Si-Sandman/usb2pa/README.md

USB2PA Project <br>
USB2 Protocol Analyzer Wing for the Papilio-Pro FPGA Board.
