Si-Sandman/usb2pa/doc/usb2pa_pinout.xls

PP Sch Sort Order | FPGA Name | Papilio Pro FPGA Pin | FPGA Usage | Papilio Pro Eagle Netname | Corresponding Papilio One Pin | LogicWing Function | USB2PA HDR | USB2PA HDR PIN | USB2PA NetName | USB2PA LogicPort Hdr Pin | USB2PA LogicPort Wire / Tip
33 | IO_L83N_VREF_3 | 1 | IOBS | CS
32 | IO_L83P_3 | 2 | IOBM | !RAS
140 | GND | 3 |  | GND
58 | VCCO_3 | 4 |  | 3V3
35 | IO_L52N_3 | 5 | IOBS | !CAS
34 | IO_L52P_3 | 6 | IOBM | !WE
37 | IO_L51N_3 | 7 | IOBS | DQML
36 | IO_L51P_3 | 8 | IOBM | DQ7
39 | IO_L50N_3 | 9 | IOBS | DQ0
38 | IO_L50P_3 | 10 | IOBM | DQ1
41 | IO_L49N_3 | 11 | IOBS | DQ2
40 | IO_L49P_3 | 12 | IOBM | DQ3
136 | GND | 13 |  | GND
43 | IO_L44N_GCLK20_3 | 14 | IOBS | DQ4
42 | IO_L44P_GCLK21_3 | 15 | IOBM | DQ5
45 | IO_L43N_GCLK22_IRDY2_3 | 16 | IOBS | DQ6
44 | IO_L43P_GCLK23_3 | 17 | IOBM | DQMH
60 | VCCO_3 | 18 |  | 3V3
129 | VCCINT | 19 |  | 1V2
123 | VCCAUX | 20 |  | 3V3
47 | IO_L42N_GCLK24_3 | 21 | IOBS | DQ8
46 | IO_L42P_GCLK25_TRDY2_3 | 22 | IOBM | DQ9
49 | IO_L41N_GCLK26_3 | 23 | IOBS | DQ10
48 | IO_L41P_GCLK27_3 | 24 | IOBM | DQ11
139 | GND | 25 |  | GND
51 | IO_L37N_3 | 26 | IOBS | DQ12
50 | IO_L37P_3 | 27 | IOBM | DQ13
130 | VCCINT | 28 |  | 1V2
53 | IO_L36N_3 | 29 | IOBS | DQ14
52 | IO_L36P_3 | 30 | IOBM | DQ15
59 | VCCO_3 | 31 |  | 3V3
55 | IO_L2N_3 | 32 | IOBS | CLK
54 | IO_L2P_3 | 33 | IOBM | CKE
57 | IO_L1N_VREF_3 | 34 | IOBS | A12
56 | IO_L1P_3 | 35 | IOBM | A11
124 | VCCAUX | 36 |  | 3V3
120 | PROGRAM_B_2 | 37 |  | REBOOT
118 | IO_L65N_CSO_B_2 | 38 | IOBS | FLASH_CS
119 | IO_L65P_INIT_B_2 | 39 | IOBM | nc
116 | IO_L64N_D9_2 | 40 | IOBS | A9
117 | IO_L64P_D8_2 | 41 | IOBM | A8
90 | VCCO_2 | 42 |  | 3V3
114 | IO_L62N_D6_2 | 43 | IOBS | A7
115 | IO_L62P_D5_2 | 44 | IOBM | A6
112 | IO_L49N_D4_2 | 45 | IOBS | A5
113 | IO_L49P_D3_2 | 46 | IOBM | A4
110 | IO_L48N_RDWR_B_VREF_2 | 47 | IOBS | W1_B16 | 22 | I-Joystick Select | PP_HDRA_B_IO | A32 | VBUS_EN | -- | --
111 | IO_L48P_D7_2 | 48 | IOBM | W1_A1 | 18 | O-AN3 | PP_HDRA_B_IO | B32 | PHYRESET (RESET) | 39 | BLU / GRN
141 | GND | 49 |  | GND
108 | IO_L31N_GCLK30_D15_2 | 50 | IOBS | W1_B15 | 25 | I-Joystick Up | PP_HDRA_B_IO | A31 | VBUS_FLAG | -- | --
109 | IO_L31P_GCLK31_D14_2 | 51 | IOBM | W1_A2 | 23 | O-DataPoint Segment | PP_HDRA_B_IO | B31 | unused
131 | VCCINT | 52 |  | 1V2
125 | VCCAUX | 53 |  | 3V3
142 | GND | 54 |  | GND
106 | IO_L30N_GCLK0_USERCCLK_2 | 55 | IOBS | W1_B14 | 32 | I-Joystick Down | PP_HDRA_B_IO | A30 | XCVRSEL0 | 32 | BRN / GRN
107 | IO_L30P_GCLK1_D13_2 | 56 | IOBM | W1_A3 | 26 | O-AN2 | PP_HDRA_B_IO | B30 | unused
104 | IO_L14N_D12_2 | 57 | IOBS | W1_B13 | 34 | I-Joystick Left | PP_HDRA_B_IO | A29 | TXREADY | 34 | ORA / GRN
105 | IO_L14P_D11_2 | 58 | IOBM | W1_A4 | 33 | O-E Segment | PP_HDRA_B_IO | B29 | TERMSEL | 31 | BLK / GRN
102 | IO_L13N_D10_2 | 59 | IOBS | W1_B12 | 36 | I-Joystick Right | PP_HDRA_B_IO | A28 | TXVALID | 28 | PUR / YEL
103 | IO_L13P_M1_2 | 60 | IOBM | GND
100 | IO_L12N_D2_MISO3_2 | 61 | IOBS | W1_A5 | 35 | O-F Segment | PP_HDRA_B_IO | B28 | SUSPENDN | 33 | RED / GRN
101 | IO_L12P_D1_MISO2_2 | 62 | IOBM | W1_B11 | 41 | O-Audio Output (delta sigma dac) |  | A27 | unused
91 | VCCO_2 | 63 |  | 3V3
98 | IO_L3N_MOSI_CSI_B_MISO0_2 | 64 | IOBS | FLASH_SI
99 | IO_L3P_D0_DIN_MISO_MISO1_2 | 65 | IOBM | FLASH_SO
96 | IO_L2N_CMPMOSI_2 | 66 | IOBS | W1_A6 | 40 | O-C Segment | PP_HDRA_B_IO | B27 | unused
97 | IO_L2P_CMPCLK_2 | 67 | IOBM | W1_A7 | 53 | O-D Segment | PP_HDRA_B_IO | B26 | unused
143 | GND | 68 |  | GND
94 | IO_L1N_M0_CMPMISO_2 | 69 | IOBS | 3V3
95 | IO_L1P_CCLK_2 | 70 | IOBM | FLASH_SCK
93 | DONE_2 | 71 |  | nc
92 | CMPCS_B_2 | 72 |  | nc
152 | SUSPEND | 73 |  | GND
87 | IO_L74N_DOUT_BUSY_1 | 74 | IOBS | W1_B9 | 58 | O-VGA Red bit1 | PP_HDRA_B_IO | A25 | RXACTIVE | 26 | GRN / YEL
88 | IO_L74P_AWAKE_1 | 75 | IOBM | W1_A8 | 57 | O-A Segment | PP_HDRA_B_IO | B25 | XCVRSEL1 | 27 | BLU / YEL
63 | VCCO_1 | 76 |  | 3V3
144 | GND | 77 |  | GND
85 | IO_L47N_1 | 78 | IOBS | W1_B8 | 61 | O-VGA Red bit0 | PP_HDRA_B_IO | A24 | OPMODE0 | 24 | ORA / YEL
86 | IO_L47P_1 | 79 | IOBM | W1_A9 | 60 | O-AN1 | PP_HDRA_B_IO | B24 | OPMODE1 | 25 | YEL / YEL
83 | IO_L46N_1 | 80 | IOBS | W1_B7 | 63 | O-VGA Grn bit2 | PP_HDRA_B_IO | A23 | unused
84 | IO_L46P__1 | 81 | IOBM | W1_A10 | 62 | O-G Segment | PP_HDRA_B_IO | B23 | unused
81 | IO_L45N_1 | 82 | IOBS | W1_B6 | 66 | O-VGA Grn bit1 | PP_HDRA_B_IO | A22 | CLKOUT (phy) | 21 | BLK / YEL
82 | IO_L45P_1 | 83 | IOBM | W1_A11 | 65 | O-B Segment | PP_HDRA_B_IO | B22 | unused
79 | IO_L43N_GCLK4_1 | 84 | IOBS | W1_B5 | 68 | O-VGA Grn bit0 | PP_HDRA_B_IO | A21 | unused
80 | IO_L43P_GCLK5_1 | 85 | IOBM | W1_A12 | 67 | O-AN0 | PP_HDRA_B_IO | B21 | unused
64 | VCCO_1 | 86 |  | 3V3 |  |  | PP_HDRA_B_IO
77 | IO_L42N_GCLK6_TRDY1_1 | 87 | IOBS | W1_B4 | 71 | O-VGA Blue bit1 | PP_HDRA_B_IO | A20 | LINESTATE0 | 17 | BLU / BLU
78 | IO_L42P_GCLK7_1 | 88 | IOBM | W1_A13 | 70 | O-ADC SPI !CS | PP_HDRA_B_IO | B20 | LINESTATE1 | 18 | PUR / BLU
132 | VCCINT | 89 |  | 1V2
126 | VCCAUX | 90 |  | 3V3
145 | GND | 91 |  | GND
75 | IO_L41N_GCLK8_1 | 92 | IOBS | W1_B3 | 78 | O-VGA Blue bit0 | PP_HDRA_B_IO | A19 | unused
76 | IO_L41P_GCLK9_IRDY1_1 | 93 | IOBM | W1_A14 | 79 | I-ADC SPI MISO | PP_HDRA_B_IO | B19 | LED5 (D5_VBUS) | 36 | GRN / GRN
73 | IO_L40N_GCLK10_1 | 94 | IOBS | OSC_IN
74 | IO_L40P_GCLK11_1 | 95 | IOBM | W1_B10 | 54 | O-VGA Red Bit2 | PP_HDRA_B_IO | A26 | unused
146 | GND | 96 |  | GND
71 | IO_L34N_1 | 97 | IOBS | W1_B2 | 83 | O-VGA Hsync | PP_HDRA_B_IO | A18 | LED1 (D1_PWR) | 16 | GRN / BLU
72 | IO_L34P_1 | 98 | IOBM | W1_A15 | 84 | O-ADC SPI MOSI | PP_HDRA_B_IO | B18 | LED4 (D4_TRIG) | 38 | PUR / GRN
69 | IO_L33N_1 | 99 | IOBS | W1_B1 | 85 | O-VGA Vsync | PP_HDRA_B_IO | A17 | LED2 (D2_ACT) | 15 | YEL / BLU
70 | IO_L33P_1 | 100 | IOBM | W1_A16 | 86 | O-ADC SPI SCLK | PP_HDRA_B_IO | B17 | LED3 (D3_CAPT) | 40 | WHT / GRN
67 | IO_L32N_1 | 101 | IOBS | USB_TXD
68 | IO_L32P_1 | 102 | IOBM | nc
62 | VCCO_1 | 103 |  | 3V3
65 | IO_L1N_VREF_1 | 104 | IOBS | nc
66 | IO_L1P_1 | 105 | IOBM | USB_RXD
149 | TDO | 106 |  | TDO
148 | TMS | 107 |  | TMS
134 | GND | 108 |  | GND
151 | TCK | 109 |  | TCK
150 | TDI | 110 |  | TDI
2 | IO_L66N_SCP0_0 | 111 | IOBS | nc
1 | IO_L66P_SCP1_0 | 112 | IOBM | LED1
135 | GND | 113 |  | GND
4 | IO_L65N_SCP2_0 | 114 | IOBS | W2_A1 | 91 | I-Switch0 | PP_HDRC_IO | A33 | HOSTDISC | 2 | BRN / WHT
3 | IO_L65P_SCP3_0 | 115 | IOBM | W2_A2 | 92 | I-Switch1 | PP_HDRC_IO | A34 | DATA7 | 1 | BLK / WHT
6 | IO_L64N_SCP4_0 | 116 | IOBS | W2_A3 | 94 | I-Switch2 | PP_HDRC_IO | A35 | DATA6 | 4 | ORA / WHT
5 | IO_L64P_SCP5_0 | 117 | IOBM | W2_A4 | 95 | I-Switch3 | PP_HDRC_IO | A36 | DATA5 | 3 | RED / WHT
8 | IO_L63N_SCP6_0 | 118 | IOBS | W2_A5 | 98 | I-Switch4 | PP_HDRC_IO | A37 | DATA4 | 6 | GRN / WHT
7 | IO_L63P_SCP7_0 | 119 | IOBM | W2_A6 | 2 | I-Switch5 | PP_HDRC_IO | A38 | DATA3 | 5 | YEL / WHT
10 | IO_L62N_VREF_0 | 120 | IOB | W2_A7 | 3 | I-Switch6 | PP_HDRC_IO | A39 | DATA2 | 8 | PUR / WHT
9 | IO_L62P_0 | 121 | IOB | W2_A8 | 4 | I-Switch7 | PP_HDRC_IO | A40 | DATA1 | 7 | BLU / WHT
29 | VCCO_0 | 122 |  | 3V3
12 | IO_L37N_GCLK12_0 | 123 | IOBS | W2_A9 | 5 | O-LED0 | PP_HDRC_IO | A41 | DATA0 | 12 | BRN / BLU
11 | IO_L37P_GCLK13_0 | 124 | IOBM | W2_A10 | 9 | O-LED1 | PP_HDRC_IO | A42 | RXVALID | 11 | BLK / BLU
28 | VCCO_0 | 125 |  | 3V3
14 | IO_L36N_GCLK14_0 | 126 | IOBS | W2_A11 | 10 | O-LED2 | PP_HDRC_IO | A43 | HOST | 14 | ORA / BLU
13 | IO_L36P_GCLK15_0 | 127 | IOBM | W2_A12 | 11 | O-LED3 | PP_HDRC_IO | A44 | RXERROR | 13 | RED / BLU
128 | VCCINT | 128 |  | 1V2
122 | VCCAUX | 129 |  | 3V3
137 | GND | 130 |  | GND
16 | IO_L35N_GCLK16_0 | 131 | IOBS | W2_A13 | 12 | O-LED4 | PP_HDRC_IO | A45 | unused
15 | IO_L35P_GCLK17_0 | 132 | IOBM | W2_A14 | 15 | O-LED5 | PP_HDRC_IO | A46 | unused
18 | IO_L34N_GCLK18_0 | 133 | IOB | W2_A15 | 16 | O-LED6 | PP_HDRC_IO | A47 | SDA
17 | IO_L34P_GCLK19_0 | 134 | IOB | W2_A16 | 17 | O-LED7 | PP_HDRC_IO | A48 | SCL
27 | VCCO_0 | 135 |  | 3V3
138 | GND | 136 |  | GND
20 | IO_L4N_0 | 137 | IOBS | A3
19 | IO_L4P_0 | 138 | IOBM | A2
22 | IO_L3N_0 | 139 | IOBS | A1
21 | IO_L3P_0 | 140 | IOBM | A0
24 | IO_L2N_0 | 141 | IOBS | A10
23 | IO_L2P_0 | 142 | IOBM | BA1
26 | IO_L1N_VREF_0 | 143 | IOBS | BA0
25 | IO_L1P_HSWAPEN_0 | 144 | IOBM | GND
30
31
61
89
121
127
133
147
