Si-Sandman/usb2pa/pcb/ppwing/eagle/usb2pa_ppwing.brd

## EAGLE design pcb/ppwing/eagle/usb2pa_ppwing.brd (2013-09-22)

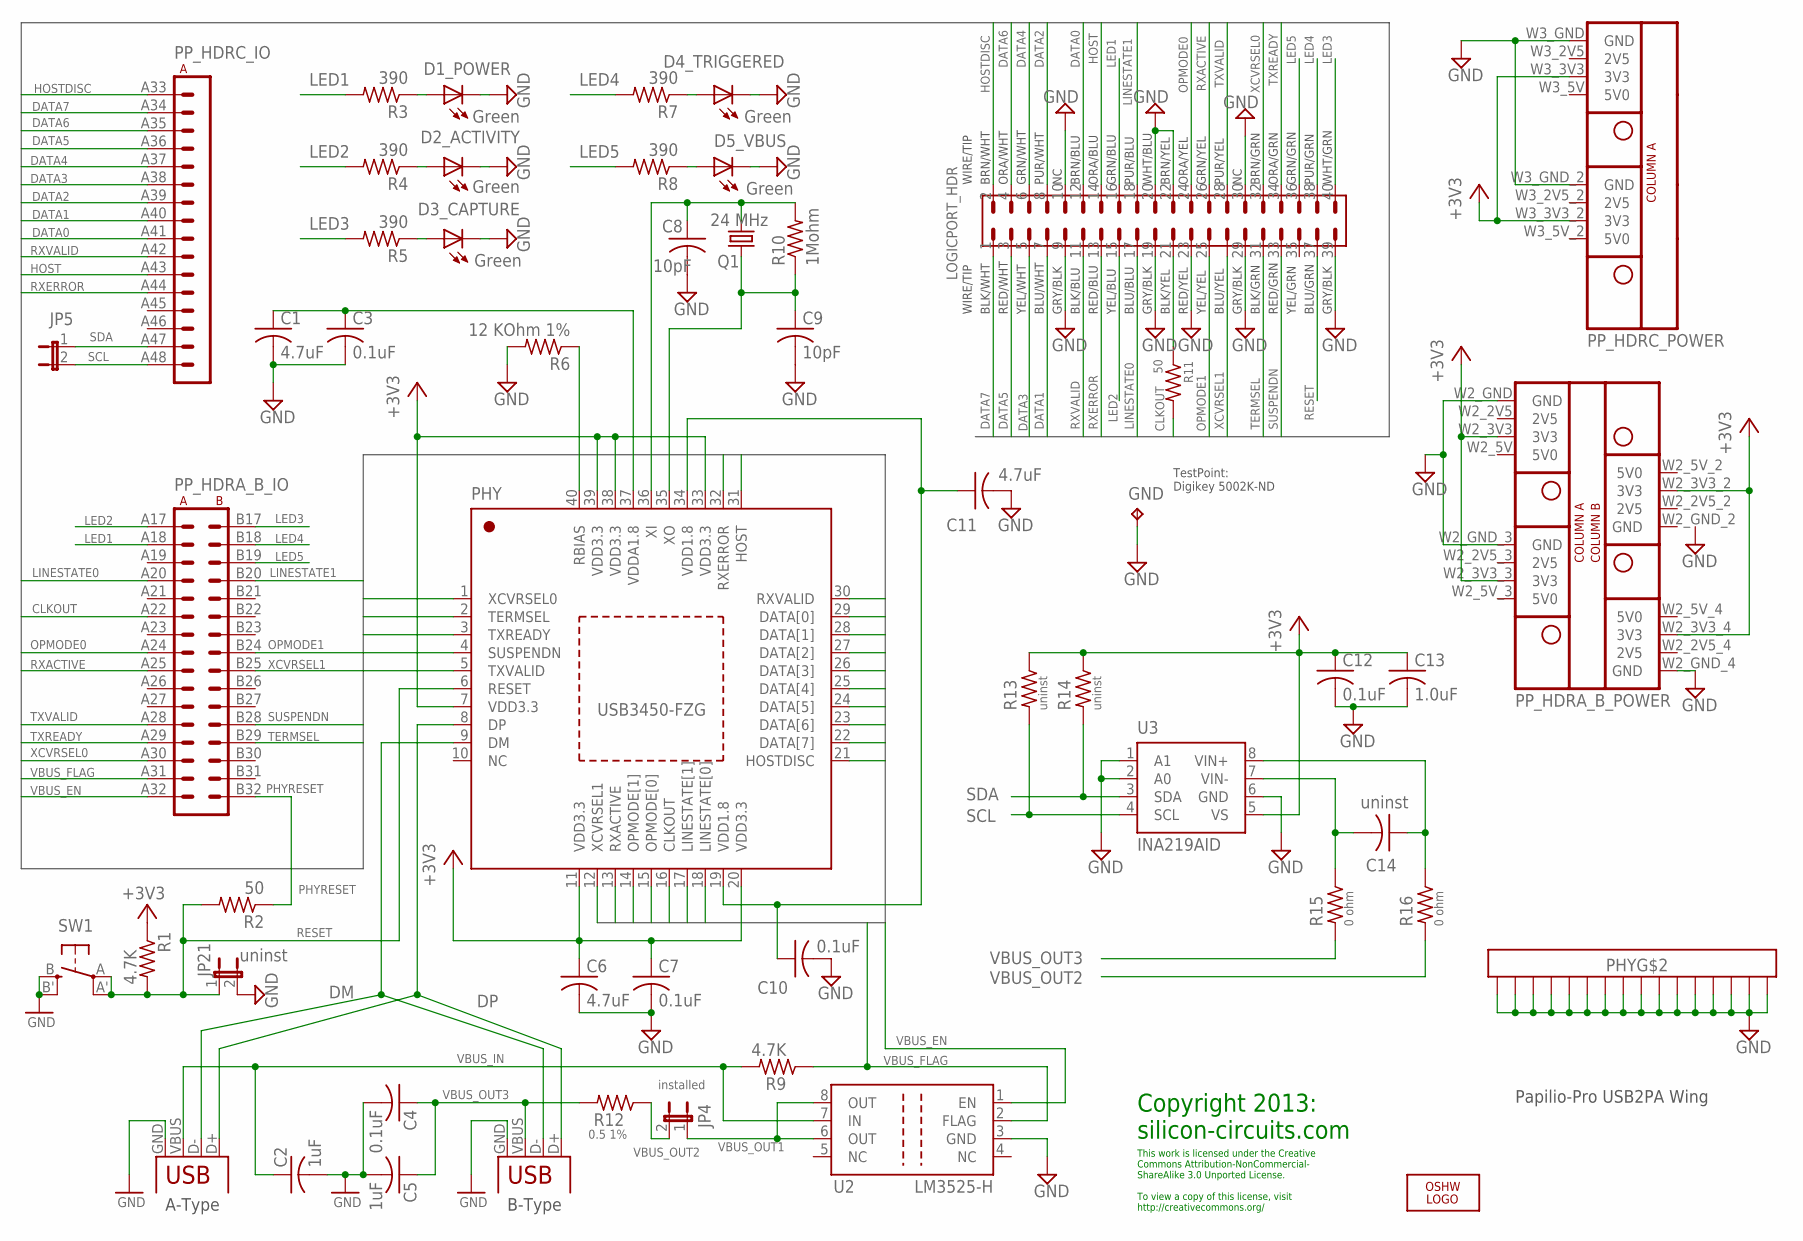
[picture p1: schematic usb2pa_ppwing.sch]

Parts:
C1, C6, C11: 4.7uF; C0805
C2, C5: 1uF; C0805
C3, C4, C7, C10, C12: 0.1uF; C0805
C8, C9: 10pF; C0805
C13: 1.0uF; C0805
C14: uninst; C0805
CC_LICENSE: CC_LICENSE
D1_POWER, D2_ACTIVITY, D3_CAPTURE, D4_TRIGGERED, D5_VBUS: Green; CHIPLED_0805
DEVICE: USB-B; USB-B-PTH
GND: TPPAD1-13; P1-13
HOST: USB-A-FEMALE-SPARKFUN_PRT-09011; USB_TYPE_A_FEMALE
JP4: installed; JP1
JP5, JP21: uninst; JP1
LOGICPORT_HDR: LOGICPORT_HDR_2X20; LOGICPORT_2X20_HEADER
LOGO1: OSHW_LOGO_FILLX0350-NT; OSHW_FILLX350_NOTEXT
PHY: USB3450-FZG; QFN40-6X6
PP_HDR: MEGAWING_FULL_P1MEGAWING_P1; MEGAWING_FULL_NOHOLES_P1
Q1: 24 MHz; HC49UP
R1, R9: 4.7K; R0805
R2, R11: 50; R0805
R3, R4, R5, R7, R8: 390; R0805
R6: 12 KOhm 1%; R0805
R10: 1Mohm; R0805
R12: 0.5 1%; R0805
R13, R14: uninst; R0805
R15, R16: 0 ohm; R0805
SW1: EVQQ2; EVQ-Q2
U2: LM3525-H; D_R-PDSO-G08
U3: INA219AID; D-R-PDSO-G8

Connections:
+3V3: C6.1, C7.1, C12.1, C13.1, PHY.7 (VDD3.3), PHY.11 (VDD3.3), PHY.20 (VDD3.3), PHY.33 (VDD3.3), PHY.38 (VDD3.3), PHY.39 (VDD3.3), PP_HDR.W2_3V3 (3V3), PP_HDR.W2_3V3_2 (3V3), PP_HDR.W2_3V3_3 (3V3), PP_HDR.W2_3V3_4 (3V3), PP_HDR.W3_3V3 (3V3), PP_HDR.W3_3V3_2 (3V3), R1.1, R13.1, R14.1, U3.5 (VS)
CLKOUT: PHY.16 (CLKOUT), PP_HDR.A22 (A6), R11.2
DATA0: LOGICPORT_HDR.12, PHY.29 (DATA[0]), PP_HDR.A41 (A9)
DATA1: LOGICPORT_HDR.7, PHY.28 (DATA[1]), PP_HDR.A40 (A8)
DATA2: LOGICPORT_HDR.8, PHY.27 (DATA[2]), PP_HDR.A39 (A7)
DATA3: LOGICPORT_HDR.5, PHY.26 (DATA[3]), PP_HDR.A38 (A6)
DATA4: LOGICPORT_HDR.6, PHY.25 (DATA[4]), PP_HDR.A37 (A5)
DATA5: LOGICPORT_HDR.3, PHY.24 (DATA[5]), PP_HDR.A36 (A4)
DATA6: LOGICPORT_HDR.4, PHY.23 (DATA[6]), PP_HDR.A35 (A3)
DATA7: LOGICPORT_HDR.1, PHY.22 (DATA[7]), PP_HDR.A34 (A2)
DM: DEVICE.D-, HOST.D-, PHY.9 (DM)
DP: DEVICE.D+, HOST.D+, PHY.8 (DP)
GND: C1.2, C2.2, C3.2, C4.2, C5.2, C6.2, C7.2, C8.2, C9.2, C10.2, C11.2, C12.2, C13.2, D1_POWER.C, D2_ACTIVITY.C, D3_CAPTURE.C, D4_TRIGGERED.C, D5_VBUS.C, DEVICE.GND, GND.TP, HOST.GND, JP21.2, LOGICPORT_HDR.9, LOGICPORT_HDR.10, LOGICPORT_HDR.19, LOGICPORT_HDR.20, LOGICPORT_HDR.22, LOGICPORT_HDR.23, LOGICPORT_HDR.29, LOGICPORT_HDR.30, LOGICPORT_HDR.39, PHY.GND@1 (EXP16), PHY.GND@2 (EXP16), PHY.GND@3 (EXP16), PHY.GND@4 (EXP16), PHY.GND@5 (EXP16), PHY.GND@6 (EXP16), PHY.GND@7 (EXP16), PHY.GND@8 (EXP16), PHY.GND@9 (EXP16), PHY.GND@10 (EXP16), PHY.GND@11 (EXP16), PHY.GND@12 (EXP16), PHY.GND@13 (EXP16), PHY.GND@14 (EXP16), PHY.GND@15 (EXP16), PHY.GND@16 (EXP16), PP_HDR.W2_GND (GND), PP_HDR.W2_GND_2 (GND), PP_HDR.W2_GND_3 (GND), PP_HDR.W2_GND_4 (GND), PP_HDR.W3_GND (GND), PP_HDR.W3_GND_2 (GND), R6.2, SW1.B (S), SW1.B' (S1), U2.3 (GND), U3.1 (A1), U3.2 (A0), U3.6 (GND)
HOST: LOGICPORT_HDR.14, PHY.31 (HOST), PP_HDR.A43 (A11)
HOSTDISC: LOGICPORT_HDR.2, PHY.21 (HOSTDISC), PP_HDR.A33 (A1)
LED1: LOGICPORT_HDR.16, PP_HDR.A18 (A2), R3.2
LED2: LOGICPORT_HDR.15, PP_HDR.A17 (A1), R4.2
LED3: LOGICPORT_HDR.40, PP_HDR.B17 (B1), R5.2
LED4: LOGICPORT_HDR.38, PP_HDR.B18 (B2), R7.2
LED5: LOGICPORT_HDR.36, PP_HDR.B19 (B3), R8.2
LINESTATE0: LOGICPORT_HDR.17, PHY.18 (LINESTATE[0]), PP_HDR.A20 (A4)
LINESTATE1: LOGICPORT_HDR.18, PHY.17 (LINESTATE[1]), PP_HDR.B20 (B4)
unnamed: LOGICPORT_HDR.21, R11.1
unnamed: D2_ACTIVITY.A, R4.1
unnamed: D3_CAPTURE.A, R5.1
unnamed: D5_VBUS.A, R8.1
unnamed: D4_TRIGGERED.A, R7.1
unnamed: D1_POWER.A, R3.1
OPMODE0: LOGICPORT_HDR.24, PHY.15 (OPMODE[0]), PP_HDR.A24 (A8)
OPMODE1: LOGICPORT_HDR.25, PHY.14 (OPMODE[1]), PP_HDR.B24 (B8)
PHYRESET: PP_HDR.B32 (B16), R2.1
RBIAS: PHY.40 (RBIAS), R6.1
RESET: JP21.1, LOGICPORT_HDR.37, PHY.6 (RESET), R1.2, R2.2, SW1.A, SW1.A' (P1)
RXACTIVE: LOGICPORT_HDR.26, PHY.13 (RXACTIVE), PP_HDR.A25 (A9)
RXERROR: LOGICPORT_HDR.13, PHY.32 (RXERROR), PP_HDR.A44 (A12)
RXVALID: LOGICPORT_HDR.11, PHY.30 (RXVALID), PP_HDR.A42 (A10)
SCL: JP5.2, PP_HDR.A48 (A16), R13.2, U3.4 (SCL)
SDA: JP5.1, PP_HDR.A47 (A15), R14.2, U3.3 (SDA)
SUSPENDN: LOGICPORT_HDR.33, PHY.4 (SUSPENDN), PP_HDR.B28 (B12)
TERMSEL: LOGICPORT_HDR.31, PHY.2 (TERMSEL), PP_HDR.B29 (B13)
TXREADY: LOGICPORT_HDR.34, PHY.3 (TXREADY), PP_HDR.A29 (A13)
TXVALID: LOGICPORT_HDR.28, PHY.5 (TXVALID), PP_HDR.A28 (A12)
VBUS_EN: PP_HDR.A32 (A16), U2.1 (EN)
VBUS_FLAG: PP_HDR.A31 (A15), R9.1, U2.2 (FLAG)
VBUS_IN: C2.1, HOST.VBUS, R9.2, U2.7 (IN)
VBUS_OUT1: JP4.1, U2.6 (OUT), U2.8 (OUT)
VBUS_OUT2: JP4.2, R12.1, R16.2
VBUS_OUT3: C4.1, C5.1, DEVICE.VBUS, R12.2, R15.2
VDD1.8: C10.1, C11.1, PHY.19 (VDD1.8), PHY.34 (VDD1.8)
VDDA1.8: C1.1, C3.1, PHY.37 (VDDA1.8)
VIN+: C14.1, R16.1, U3.8 (VIN+)
VIN-: C14.2, R15.1, U3.7 (VIN-)
XCVRSEL0: LOGICPORT_HDR.32, PHY.1 (XCVRSEL0), PP_HDR.A30 (A14)
XCVRSEL1: LOGICPORT_HDR.27, PHY.12 (XCVRSEL1), PP_HDR.B25 (B9)
XI: C8.1, PHY.36 (XI), Q1.2, R10.2
XO: C9.1, PHY.35 (XO), Q1.1, R10.1

Notes on the sheet:
Papilio-Pro USB2PA Wing
B-Type
A-Type
TestPoint: Digikey 5002K-ND
Copyright 2013: silicon-circuits.com
This work is licensed under the Creative Commons Attribution-NonCommercial- ShareAlike 3.0 Unported License. To view a copy of this license, visit http://creativecommons.org/

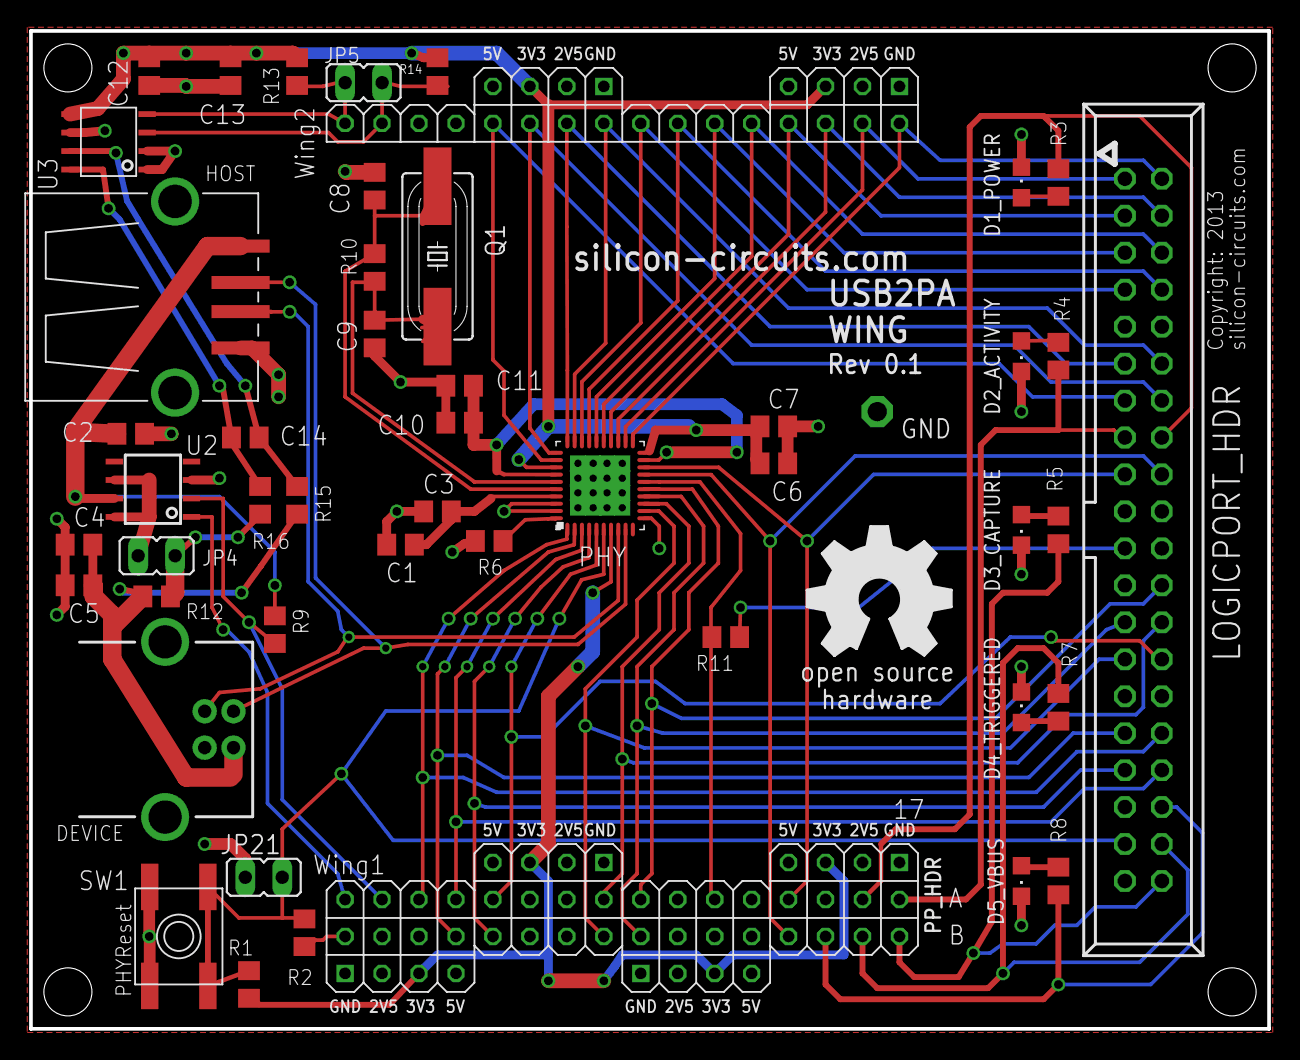
[picture p2: board usb2pa_ppwing.brd from above]

Board: 2 copper layers, 85.1 x 68.6 mm, 54 parts (0 on the bottom side), 56 nets.

Other parts of the board:
JP1, JP2, JP3, JP7: STAND-OFF
