Si-Sandman/usb2pa/(commit log)

2013-09-22 Initial commit for usb2pa rev0p1 prototyping board.
    [USBPA2_rev0p1.GBL, USBPA2_rev0p1.GBO, USBPA2_rev0p1.GBS, USBPA2_rev0p1.GKO, USBPA2_rev0p1.GTL, USBPA2_rev0p1.GTO, USBPA2_rev0p1.GTP, USBPA2_rev0p1.GTS]
2013-09-22 REV0P1a : This is what was actually submitted to the board shop.
    [usb2pa_ppwing.brd, usb2pa_ppwing.sch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]
